JonasNorling/guitarboard/hw/schematic.pdf

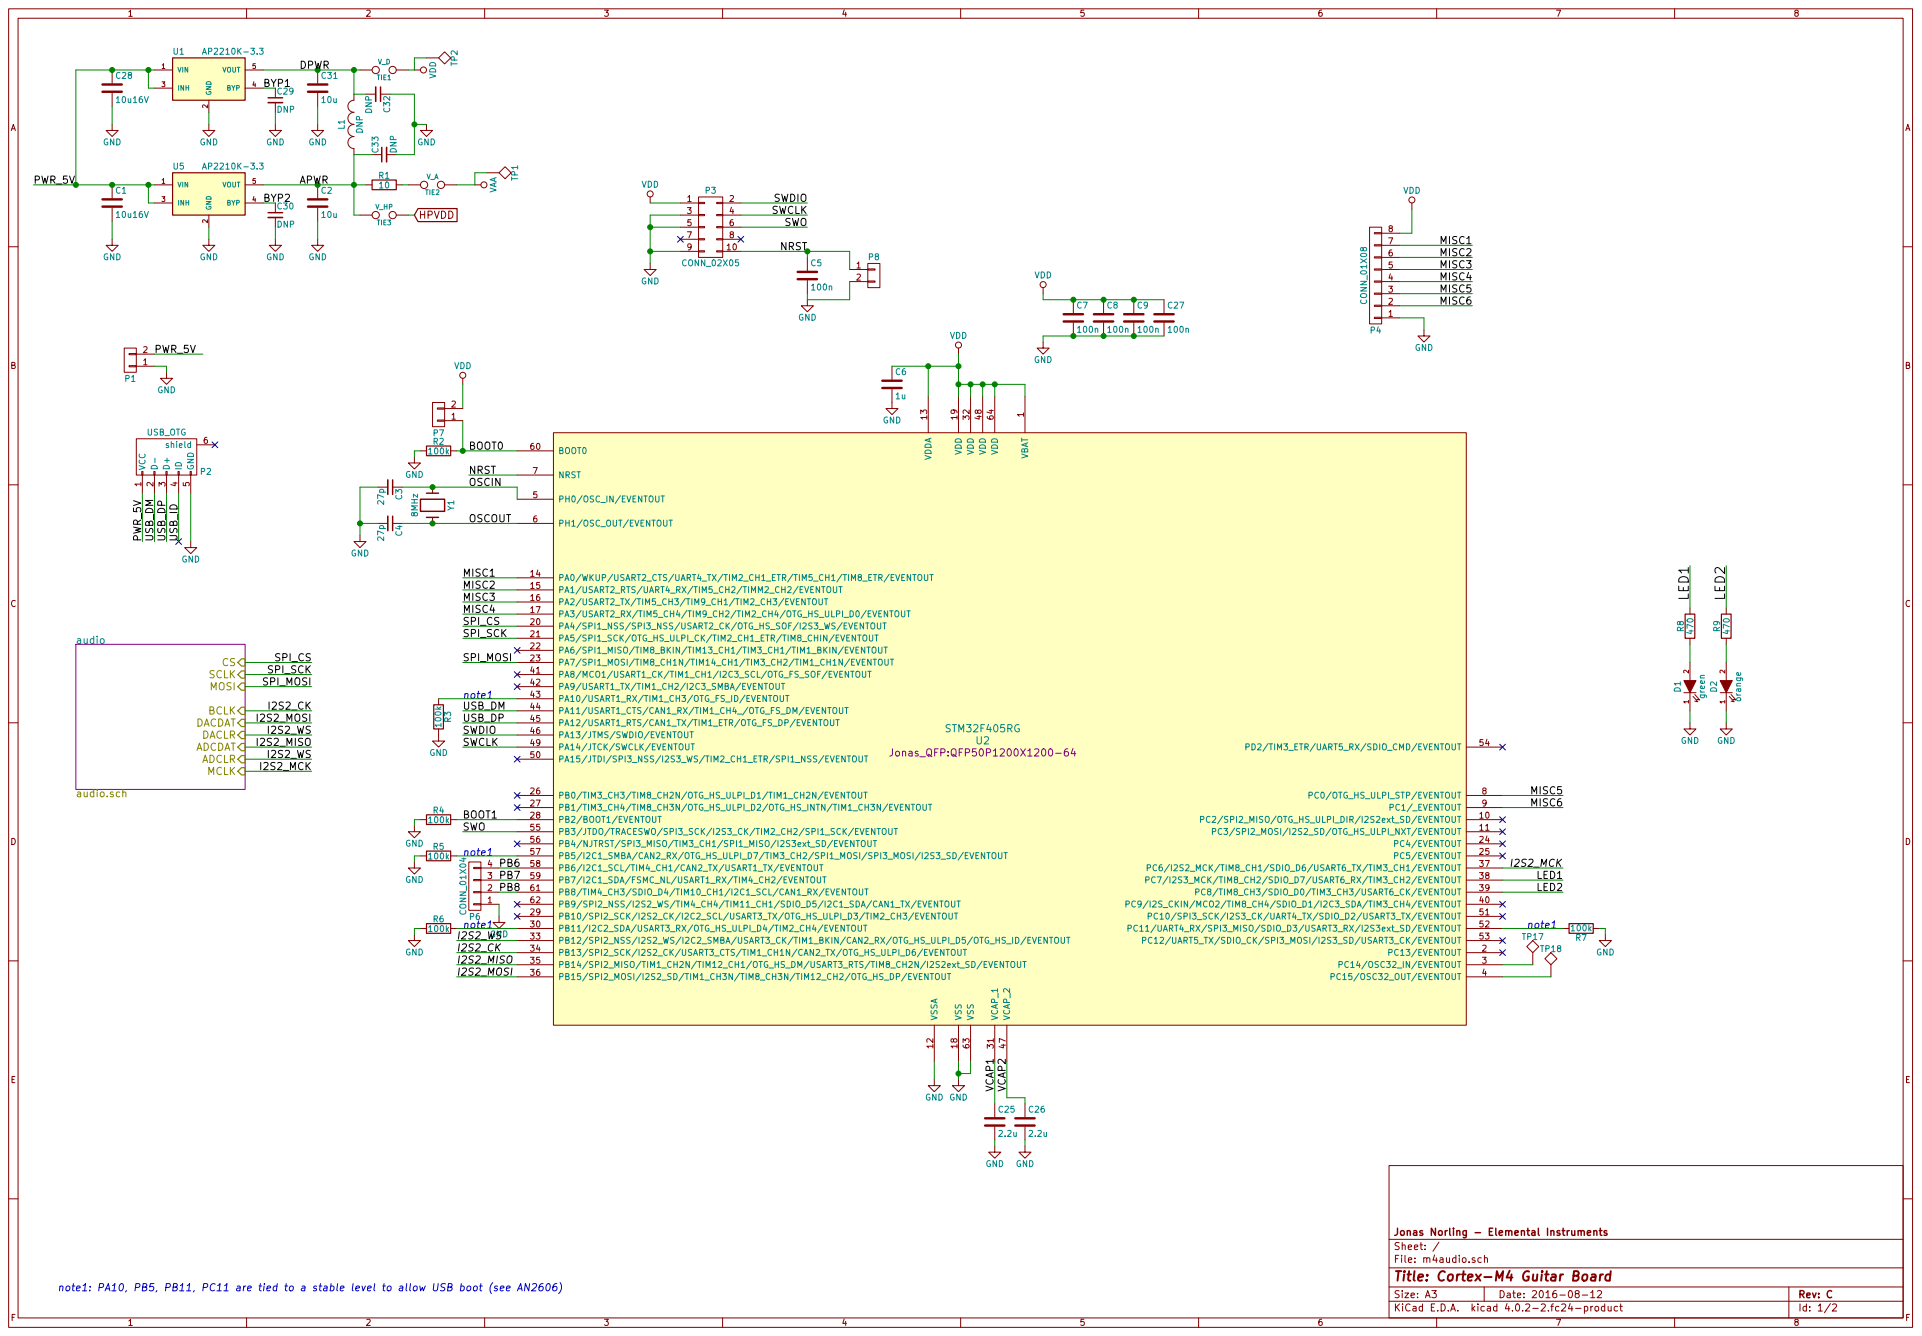
[picture p3: page 1]

5 | 6 SWO
7 | 8 NRST

File: m4audio.sch Sheet: / Jonas Norling - Elemental Instruments VBAT

Id: 1/2 Title: Cortex-M4 Guitar Board

note1: PA10, PB5, PB11, PC11 are tied to a stable level to allow USB boot (see AN2606)

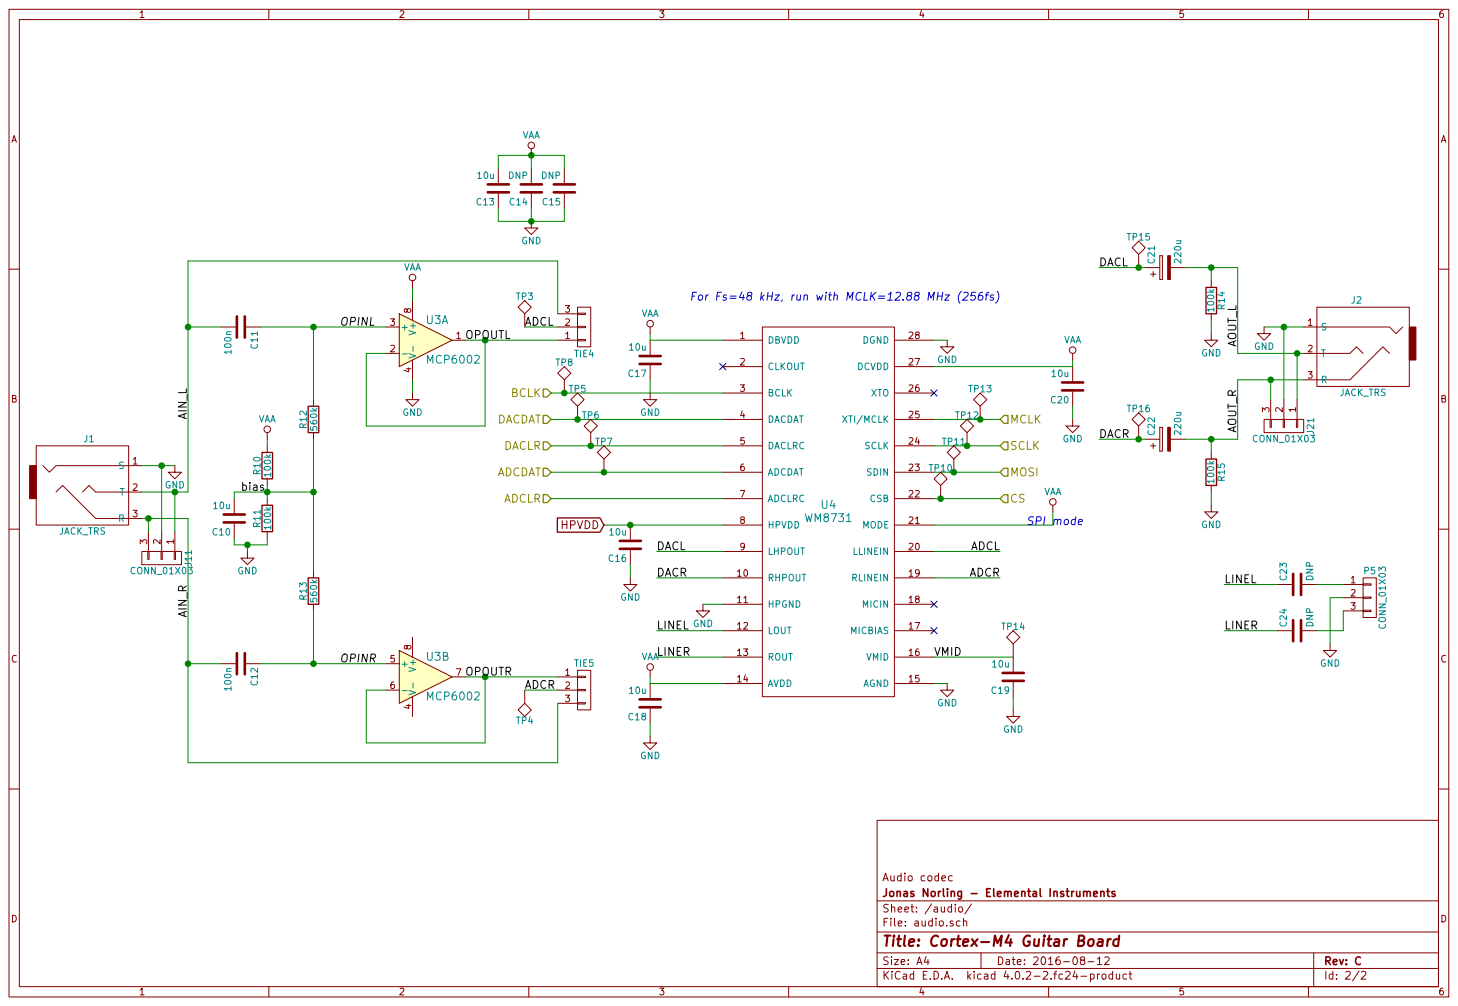
[picture p4: page 2]

Id: 2/2 Title: Cortex-M4 Guitar Board
