JonasNorling/guitarboard/hw/assembly.pdf

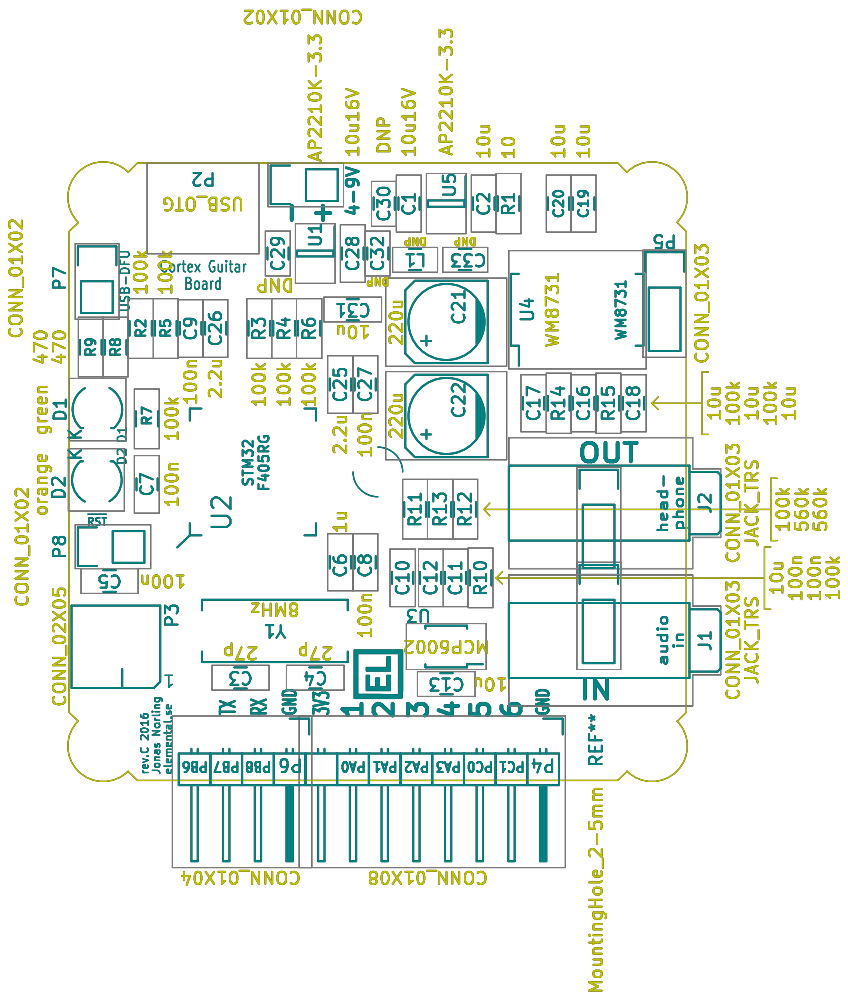
[picture p5: page 1]
