JonasNorling/guitarboard/hw/m4audio.kicad_pcb

## KiCad design hw/m4audio.kicad_pcb (2016-08-21)

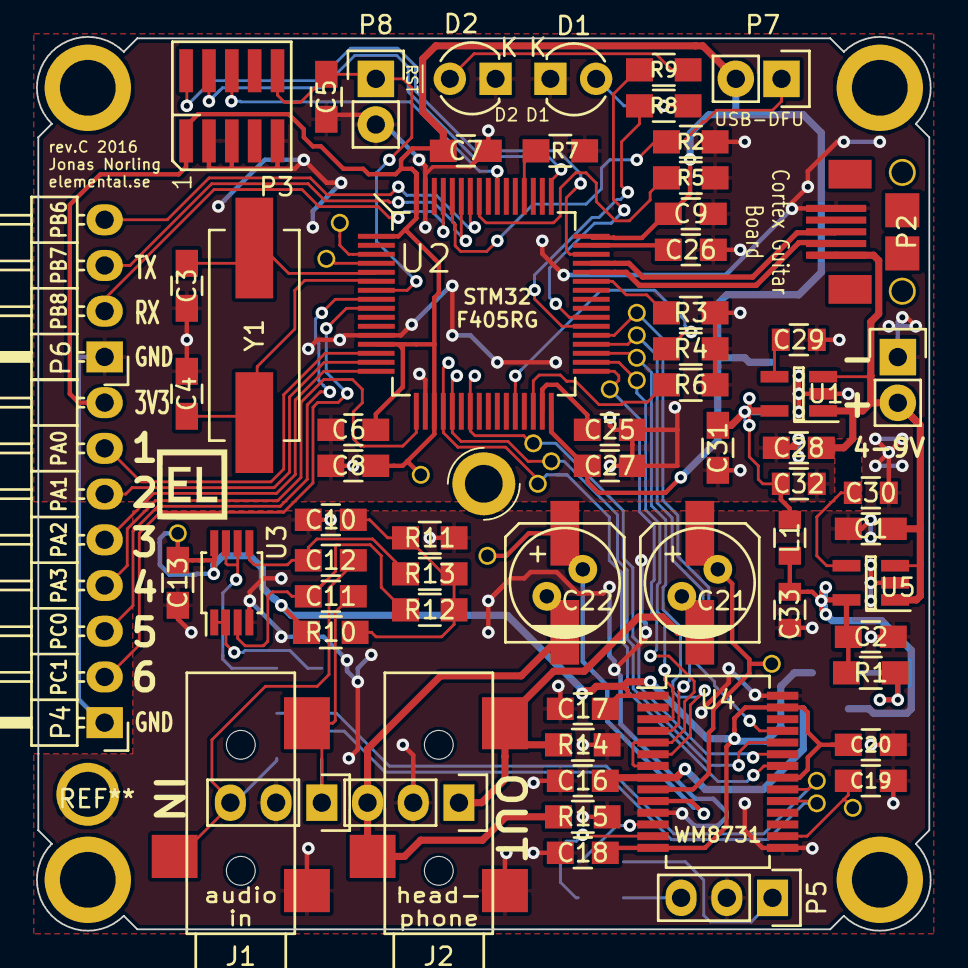
[picture p6: board m4audio.kicad_pcb from above]

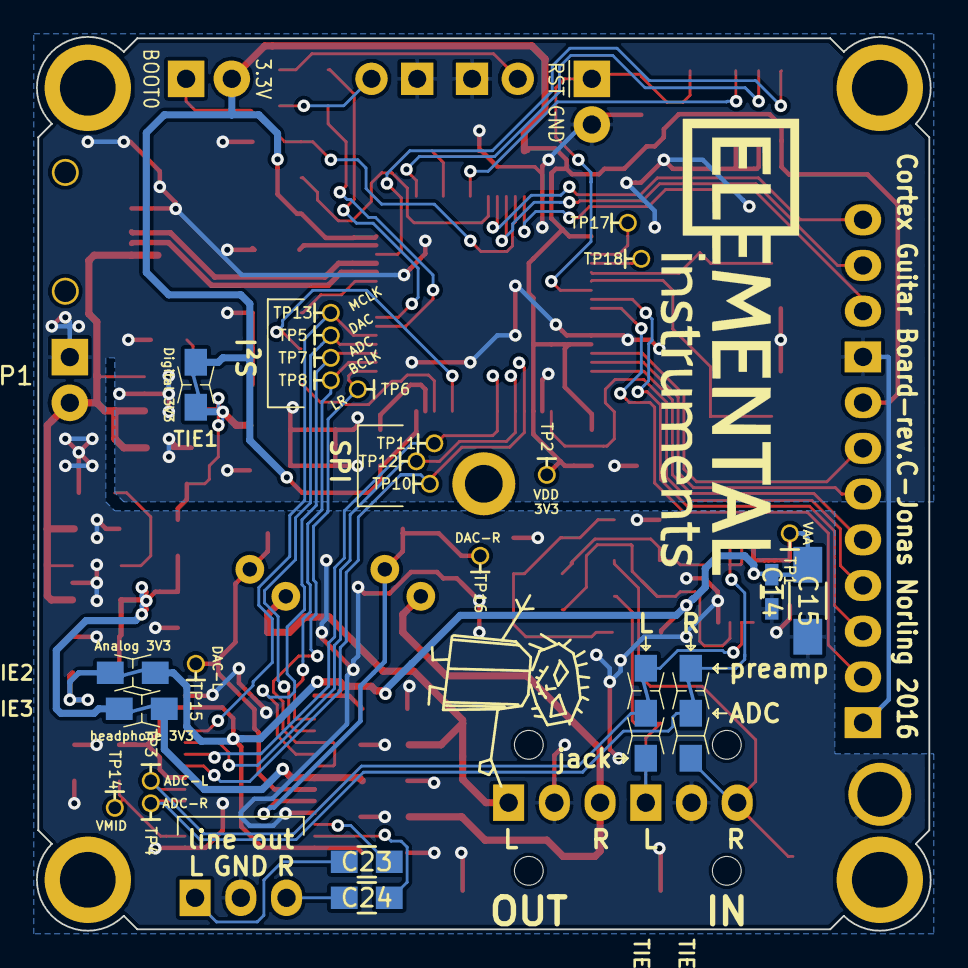
[picture p7: board m4audio.kicad_pcb from below]

Board: 2 copper layers, 49.7 x 49.7 mm, 91 parts (26 on the bottom side), 67 nets.

Parts:
C1, C28: 10u16V; C_0805_HandSoldering
C2, C10, C13, C16, C17, C18, C19, C20, C31: 10u; C_0805_HandSoldering
C3, C4: 27p; C_0805_HandSoldering
C5, C7, C8, C9, C11, C12, C27: 100n; C_0805_HandSoldering
C6: 1u; C_0805_HandSoldering
C14: DNP; C_0603_HandSoldering
C15: DNP; C_1206_HandSoldering
C21, C22: 220u; c_elec_6.3x7.7
C23, C24: DNP; C_0805_HandSoldering
C25, C26: 2.2u; C_0805_HandSoldering
C29, C30, C32, C33: DNP; C_0805
D1: green; LED-3MM
D2: orange; LED-3MM
J1, J2: JACK_TRS; 35RASMT2BHNTRX
J11, J21: CONN_01X03; Pin_Header_Straight_1x03
L1: DNP; C_0805
P1, P7, P8: CONN_01X02; Pin_Header_Straight_1x02
P2: USB_OTG; USB_Micro_FCI
P3: CONN_02X05; Pin_Header_SMT_1.27_2x5
P4: CONN_01X08; Pin_Header_Angled_1x08
P5: CONN_01X03; Pin_Header_Straight_1x03
P6: CONN_01X04; Pin_Header_Angled_1x04
R1: 10; R_0805_HandSoldering
R2, R3, R4, R5, R6, R7, R10, R11, R14, R15: 100k; R_0805_HandSoldering
R8, R9: 470; R_0805_HandSoldering
R12, R13: 560k; R_0805_HandSoldering
TIE1: V_D; net_tie_0805
TIE2: V_A; net_tie_0805
TIE3: V_HP; net_tie_0805
TIE4, TIE5: CONN_01X03; net_tie_3_0805
TP1, TP2, TP3, TP4, TP5, TP6, TP7, TP8, TP10, TP11, TP12, TP13, TP14, TP15, TP16, TP17, TP18: TST; TP_0.7mm
U1, U5: AP2210K-3.3; SOT-23-5_Handsoldering
U2: STM32F405RG; QFP50P1200X1200-64
U3: MCP6002; MSOP-8_3x3mm_Pitch0.65mm
U4: WM8731; SSOP-28_5.3x10.2mm_Pitch0.65mm
Y1: 8MHz; Crystal_HC49-SD_SMD

Connections:
/APWR: C2.1, C33.1, L1.1, R1.1, TIE3.2, U5.5
/BOOT0: P7.1, R2.2, U2.60
/BOOT1: R4.2, U2.28
/BYP1: C29.1, U1.4
/BYP2: C30.1, U5.4
/DPWR: C31.1, C32.2, L1.2, TIE1.2, U1.5
/LED1: R8.2, U2.38
/LED2: R9.2, U2.39
/MISC1: P4.7, U2.14
/MISC2: P4.6, U2.15
/MISC3: P4.5, U2.16
/MISC4: P4.4, U2.17
/MISC5: P4.3, U2.8
/MISC6: P4.2, U2.9
/NRST: C5.1, P3.10, P8.1, U2.7
/OSCIN: C3.1, U2.5, Y1.1
/OSCOUT: C4.1, U2.6, Y1.2
/PB6: P6.4, U2.58
/PB7: P6.3, U2.59
/PB8: P6.2, U2.61
/PWR_5V: C1.1, C28.1, P1.2, P2.1, U1.1, U1.3, U5.1, U5.3
/SWCLK: P3.4, U2.49
/SWDIO: P3.2, U2.46
/SWO: P3.6, U2.55
/USB_DM: P2.2, U2.44
/USB_DP: P2.3, U2.45
/VCAP1: C25.1, U2.31
/VCAP2: C26.1, U2.47
/audio/ADCDAT: TP7.1, U2.35, U4.6
/audio/ADCL: TIE4.2, TP3.1, U4.20
/audio/ADCLR: TP6.1, U2.33, U4.5, U4.7
/audio/ADCR: TIE5.2, TP4.1, U4.19
/audio/AIN_L: C11.2, J1.2, J11.1, TIE4.3
/audio/AIN_R: C12.2, J1.3, J11.3, TIE5.3
/audio/AOUT_L: C21.2, J2.2, J21.1, R14.1
/audio/AOUT_R: C22.2, J2.3, J21.3, R15.1
/audio/BCLK: TP8.1, U2.34, U4.3
/audio/CS: TP10.1, U2.20, U4.22
/audio/DACDAT: TP5.1, U2.36, U4.4
/audio/DACL: C21.1, TP15.1, U4.9
/audio/DACR: C22.1, TP16.1, U4.10
/audio/LINEL: C23.1, U4.12
/audio/LINER: C24.1, U4.13
/audio/MCLK: TP13.1, U2.37, U4.25
/audio/MOSI: TP11.1, U2.23, U4.23
/audio/OPINL: C11.1, R12.2, U3.3
/audio/OPINR: C12.1, R13.1, U3.5
/audio/OPOUTL: TIE4.1, U3.1, U3.2
/audio/OPOUTR: TIE5.1, U3.6, U3.7
/audio/SCLK: TP12.1, U2.21, U4.24
/audio/VMID: C19.2, TP14.1, U4.16
/audio/bias: C10.2, R10.1, R11.2, R12.1, R13.2
GND: C1.2, C2.2, C3.2, C4.2, C5.2, C6.2, C7.2, C8.2, C9.2, C10.1, C13.1, C14.1, C15.1, C16.1, C17.1, C18.1, C19.1, C20.1, C25.2, C26.2, C27.2, C28.2, C29.2, C30.2, C31.2, C32.1, C33.2, D1.1, D2.1, J1.1, J2.1, J11.2, J21.2, P1.1, P2.5, P3.3, P3.5, P3.9, P4.1, P5.2, P6.1, P8.2, R2.1, R3.2, R4.1, R5.1, R6.1, R7.1, R11.1, R14.2, R15.2, U1.2, U2.12, U2.18, U2.63, U3.4, U4.11, U4.15, U4.28, U5.2
HPVDD: C16.2, TIE3.1, U4.8
unnamed: C23.2, P5.1
unnamed: C24.2, P5.3
unnamed: D1.2, R8.1
unnamed: D2.2, R9.1
unnamed: R1.2, TIE2.2
unnamed: R3.1, U2.43
unnamed: R5.2, U2.57
unnamed: R6.2, U2.30
unnamed: R7.2, U2.52
unnamed: TP17.1, U2.3
unnamed: TP18.1, U2.4
VAA: C13.2, C14.2, C15.2, C17.2, C18.2, C20.2, R10.2, TIE2.1, TP1.1, U3.8, U4.1, U4.14, U4.21, U4.27
VDD: C6.1, C7.1, C8.1, C9.1, C27.1, P3.1, P4.8, P7.2, TIE1.1, TP2.1, U2.1, U2.13, U2.19, U2.32, U2.48, U2.64
