JonasNorling/guitarboard/(commit log)

2015-08-04 PCB updates
    [audio.sch, m4audio.kicad_pcb, m4audio.sch]
2015-08-05 Change to electrolytic cap, routing
    [audio.sch, m4audio.kicad_pcb, m4audio.sch]
2015-08-08 Add WM8731 audio codec
    [audio.sch, m4audio.kicad_pcb, m4audio.sch]
2015-08-08 Add a gnome
    [m4audio.kicad_pcb]
2015-08-08 Tuning PCB
    [m4audio.kicad_pcb]
2015-08-09 Use only one supply net name, add VCAP on STM32, alternative LED footprints
    [audio.sch, m4audio.kicad_pcb, m4audio.sch]
2015-08-09 Tune PCB design, add protection diode
    [audio.sch, m4audio.kicad_pcb, m4audio.sch]
2015-08-09 Add I2S test pads
    [audio.sch, m4audio.kicad_pcb]
2015-08-09 Standardise on 100k for random stuff
    [audio.sch, m4audio.kicad_pcb, m4audio.sch]
2015-08-09 Tune values, add BOM
    [audio.sch, m4audio.sch]
2015-08-09 Adding Gerbers used for OSH Park order
2015-08-29 Board bringup
    - The Codec can output audio though the headphone connectors
2015-08-29 Sinewave example
    There is still plenty of time available per frame.
2015-08-29 DMA data from ADC
2015-08-29 LED abstraction
2015-09-06 Add biquad filter core, Wahwah effect, utils for buffer conversion
2015-09-17 Vibrato effect
    knob0 - depth
    knob1 - speed
    knob2 - tubelike distortion
    knob3 - stereo effect (phase difference L/R)
2015-09-24 Recalculate delay each sample, yields smoother changes
2015-09-24 Pitch pedal effect, not very enjoyable
2015-09-26 Board update and ripup: split power supply, 49.5mm size
    [audio.sch, m4audio.kicad_pcb, m4audio.sch]
2015-09-26 Remove USB resistor, the STM32 has one built in
    [m4audio.kicad_pcb, m4audio.sch]
2015-09-26 Make TPs a bit larger
    [m4audio.kicad_pcb]
2015-10-01 Put a 2mm hole in the middle, adjust routing
    [m4audio.kicad_pcb]
2015-10-03 Small fixes to routing, silkscreen
    [m4audio.kicad_pcb]
2015-10-03 Tidy up routing, add OSHW logo
    [m4audio.kicad_pcb]
2015-10-03 Board revision B finished
    [m4audio.kicad_pcb, m4audio.sch]
2015-10-05 Add missing STM32 library
2015-10-05 Update schematic metadata
    [audio.sch, m4audio.kicad_pcb, m4audio.sch]
2015-10-05 Use Gerber filenames for ITEAD
2015-11-21 Embedded guitar board software
    Support a board embedded in a guitar, with four knobs and a
    three-position switch connected.
    Select the effect to use based on the switch: delay - clean - vibrato.
    - Add functions for setting codec volume
    - Add knob configuration (ADC or GPIO input with pullup)
2016-07-06 Program for an effects box with switches
2016-07-06 Re-save board with KiCad 4.0, fix small compatibility error
    [audio.sch, m4audio.kicad_pcb, m4audio.sch]
2016-07-06 Turn off reference and value on silkscreen in Gerber
    [m4audio.kicad_pcb]
2016-07-08 Adjust testpoint drill and annular, for ITEAD production
    [audio.sch, m4audio.kicad_pcb]
2016-07-08 Add RST test point
    [audio.sch, m4audio.kicad_pcb, m4audio.sch]
2016-07-09 Use dual SMT/through hole footprint for caps
    [audio.sch, m4audio.kicad_pcb]
2016-07-09 Silkscreen text fixes
    [m4audio.kicad_pcb]
2016-07-16 Change LED footprints and resistors, RST header, hole in GND pad
    [m4audio.kicad_pcb, m4audio.sch]
2016-07-24 Redo power supply, split ground plane
    Change to using two SOT-23-5 voltage regulators, one for analog and
    one for digital. Split the ground plane so that digital and analog
    meat at only one point, hoping to improve ground coupled noise
    performance.
    Update silkscreen texts to "rev.C".
    Move silkscreen texts.
    [audio.sch, m4audio.kicad_pcb, m4audio.sch]
2016-07-24 Net tie to bypass the pre-amp
    [audio.sch, m4audio.kicad_pcb]
2016-07-25 Tiny silk fixes
    [m4audio.kicad_pcb]
2016-07-26 Tiny routing fixes
    [m4audio.kicad_pcb]
2016-08-05 Adjust USB interrupts, reset, re-enable USB log
    Logging over USB has been pretty flaky, device enumeration often not
    working. There have been hints that the USB interrupt isn't serviced
    quickly enough, but also about the interrupt not happening at all.
    Trying to fix this by properly setting up interrupt priorities so that
    USB can preempt everything else and get its shit done quickly. Trying
    to reset the USB peripheral more thoroughly, and trying to not block
    in _write() when the host isn't polling us (which happens when the
    port is closed).
    This seems to work, but the nature of USB is that you never know if it
    still works tomorrow.
2016-08-06 Update BOM
2016-08-12 Add README about the board layout, update root README
2016-08-12 Add schematic PDF
    [audio.sch, m4audio.sch]
2016-08-13 Add gerbers for rev.C, move them
2016-08-13 Move value texts, make PDF with assembly drawing
    [audio.sch, m4audio.kicad_pcb, m4audio.sch]
2016-08-13 Convert BOM to CSV format
    So that people without Gnumeric can read it.
    [bom.csv]
2016-08-14 Change LED pins, for rev.C board
    Also make the feedthrough program blink in a more enticing manner.
2016-08-21 Update BOM/schematic with component choices
    Using MCP6002 opamp, 10 ohms impedance on analog supply, not
    populating voltage regulator bypass cap by default.
    [audio.sch, bom.csv, m4audio.kicad_pcb, m4audio.sch]
2016-08-24 Read the right audio-in DMA buffer at the right time
    It seems like we've been reading the wrong buffer, but getting away
    with it because we generally read the samples right away to convert
    them to floats.
    Now using the "input" DMA interrupt, which comes 20us later, because
    the last sample hasn't been DMA's in yet when the "output" interrupt
    comes.
2016-08-24 Disable automatic high-pass in ADC, doing it in software
    This fixes some noise issues with the WM8731 codec, for some weird
    reasons. The ADC really doesn't like it when it's quiet, when it's
    sitting just around digital 0, and it seems to start to invent
    noise. Disabling removing of the DC bias (an offset which seems to be
    internal to the codec anyway) makes the signal much cleaner when the
    input is absolutely quiet. The DC bias is now removed in software
    instead.
    When testing this I have noticed that it makes a difference what the
    DAC does too, even if it is muted or at a very low volume level. It
    doesn't like absolute silence either, in which case the ADC produces
    some noise tones at a few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
2016-09-03 USB audio: send the right number of samples each frame
    We run in asynchronous mode and send the number of samples that are
    actually available per USB frame to the host. How many samples have
    trickled in since the last USB frame is deduced by looking at where
    the DMA job writes to the input buffer when it's time to fill the USB
    buffer.
    I think there may be artefacts when starting to send audio; the code
    for starting to sync up DMA and USB buffers is naive (well, it doesn't
    really exist).
2016-09-24 Make WM8731 highpass build-time configurable
    With the automatic DC removal disabled the ADC range is narrower,
    leading to more clipping in some situations. It is now disabled by
    default, but can be enabled by uncommenting a line in wm8731.c.
    Also, change FFT test parameters.
2018-03-19 Time how long it takes to process each frame
2018-03-24 Sawsynth: add lowpass filter
2018-03-28 Sawsynth: volume and filter envelopes
